vegos/TriggerAid/TriggerAid_prototype.jpg

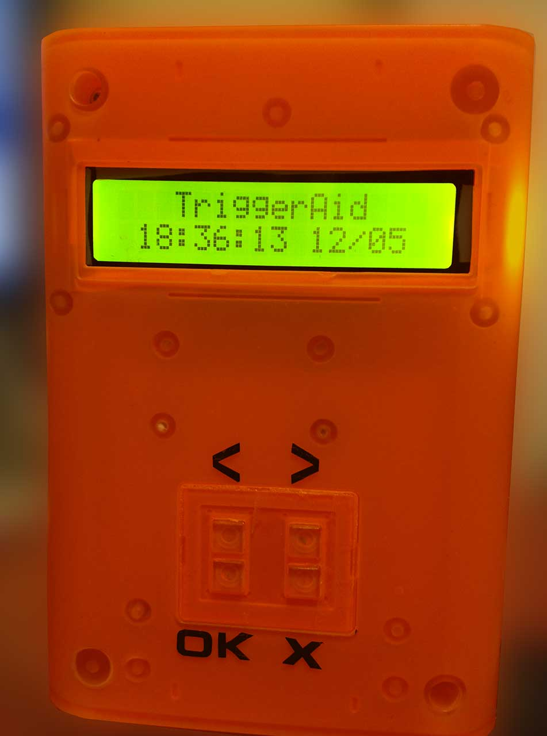
TriggerAid_prototype.jpg
