vegos/TriggerAid/TriggerAid2.jpg

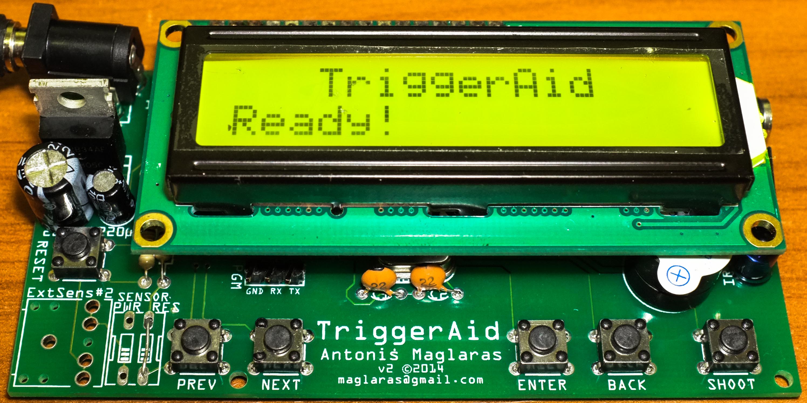
TriggerAid2.jpg
