vegos/TriggerAid/TriggerAidPCB.png

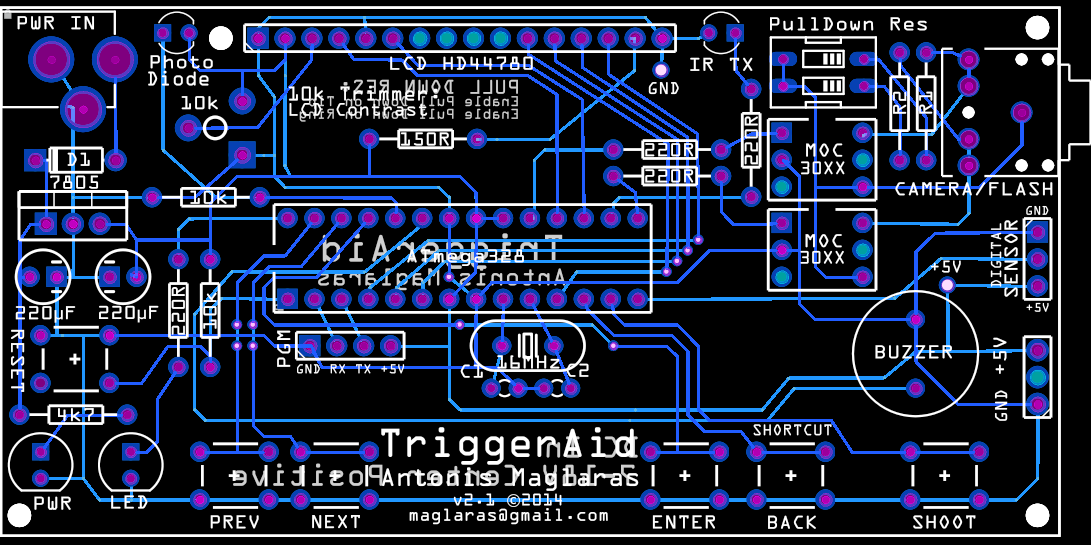
TriggerAidPCB.png
