vegos/TriggerAid/PCB/TriggerAid_etch_copper_bottom.pdf

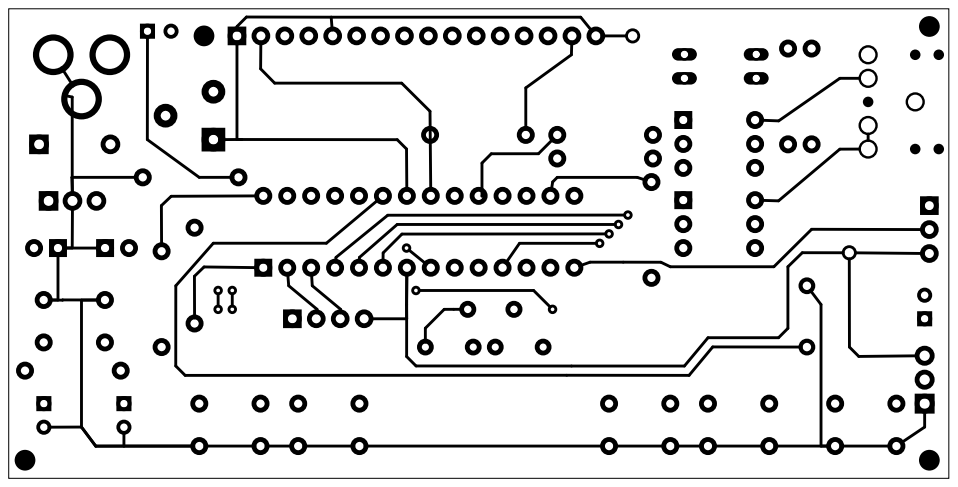
[picture p5: page 1]
