vegos/TriggerAid/PCB/TriggerAid_etch_copper_bottom_mirror.pdf

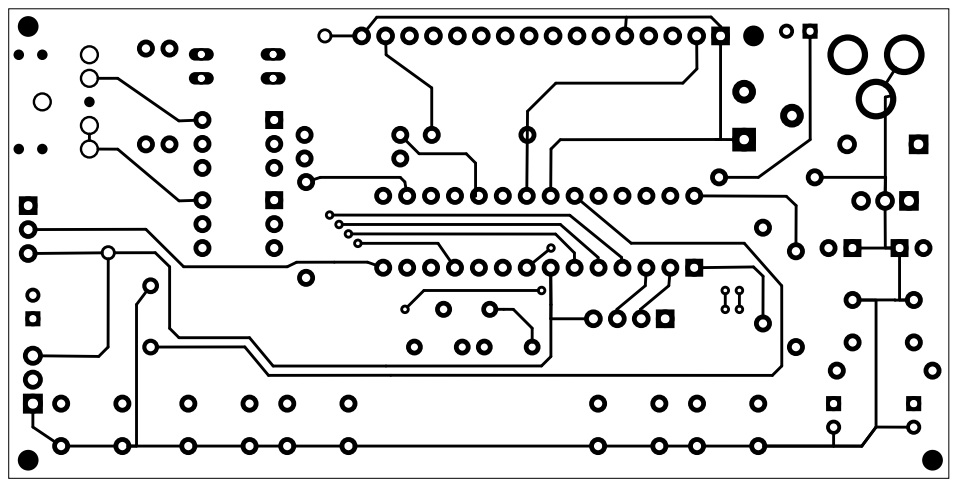
[picture p6: page 1]
