vegos/TriggerAid/PCB/TriggerAid_etch_copper_top.pdf

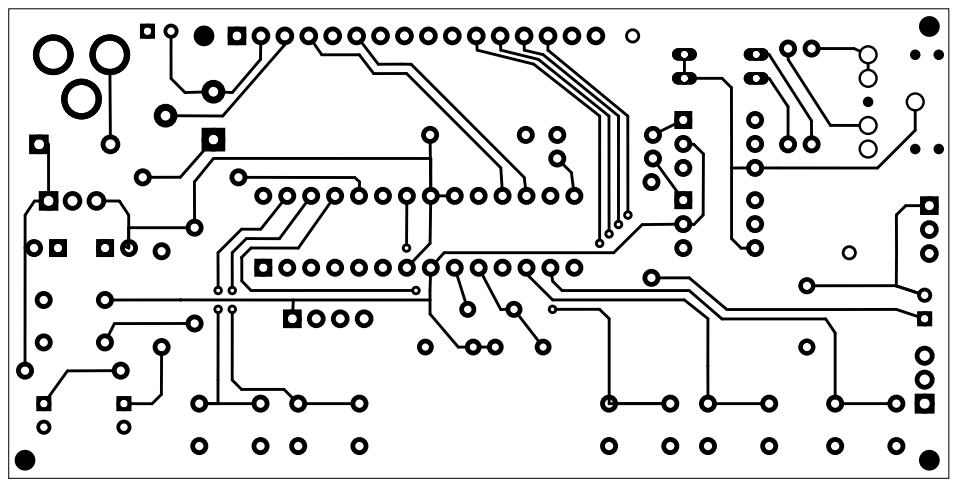
[picture p7: page 1]
