vegos/TriggerAid/PCB/TriggerAid_etch_copper_top_mirror.pdf

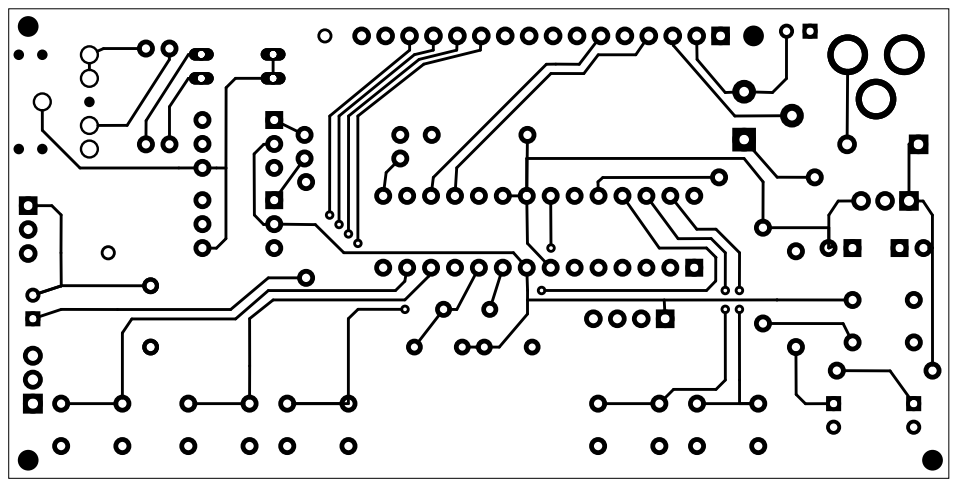
[picture p8: page 1]
