vegos/TriggerAid/PCB/TriggerAid_etch_mask_bottom.pdf

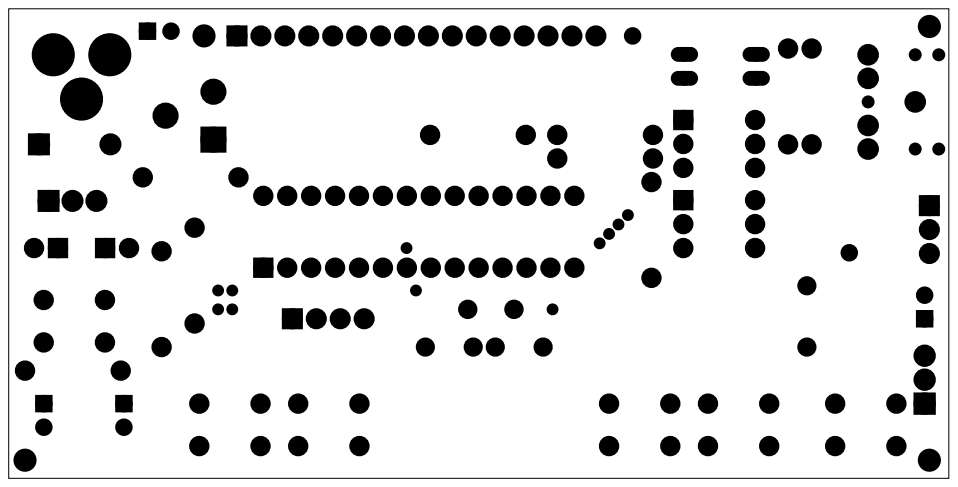
[picture p9: page 1]
