vegos/TriggerAid/PCB/TriggerAid_etch_mask_bottom_mirror.pdf

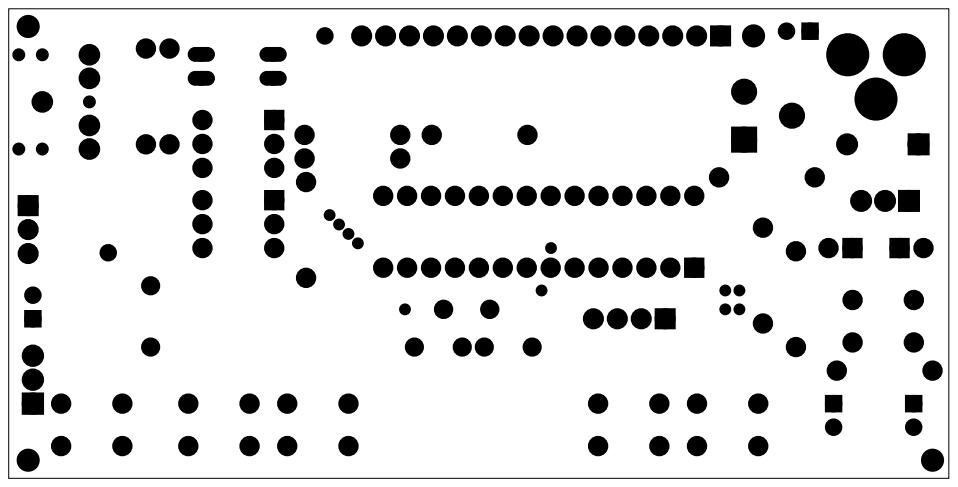
[picture p10: page 1]
