vegos/TriggerAid/PCB/TriggerAid_etch_mask_top.pdf

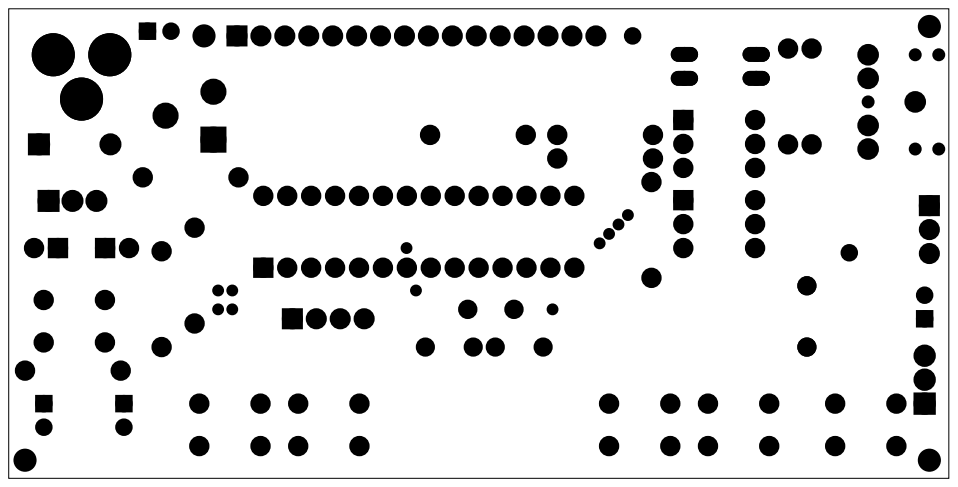
[picture p11: page 1]
