vegos/TriggerAid/PCB/TriggerAid_etch_mask_top_mirror.pdf

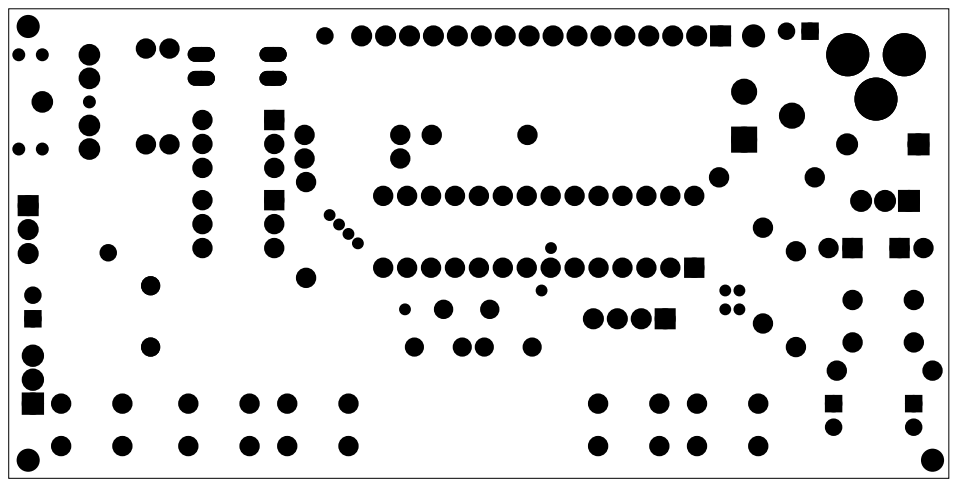
[picture p12: page 1]
