vegos/TriggerAid/PCB/TriggerAid_etch_silk_bottom.pdf

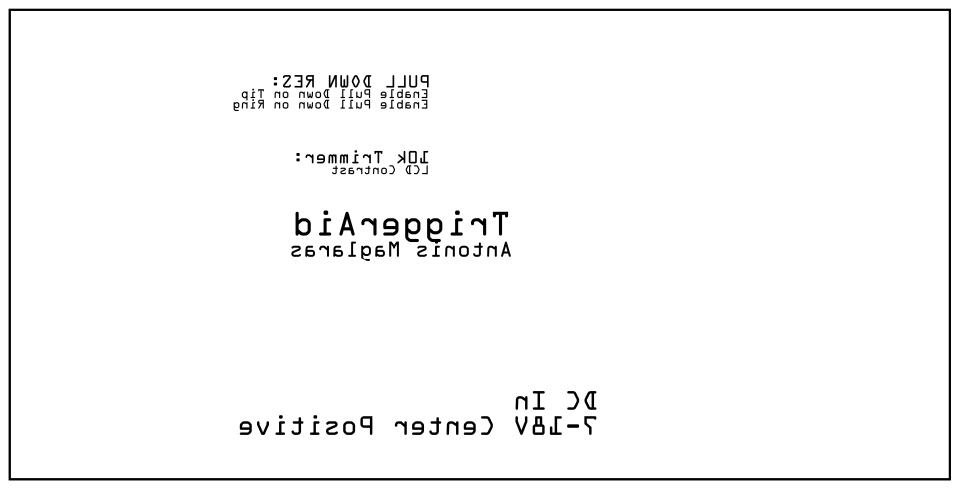
[picture p13: page 1]
