vegos/TriggerAid/PCB/TriggerAid_etch_silk_bottom_mirror.pdf

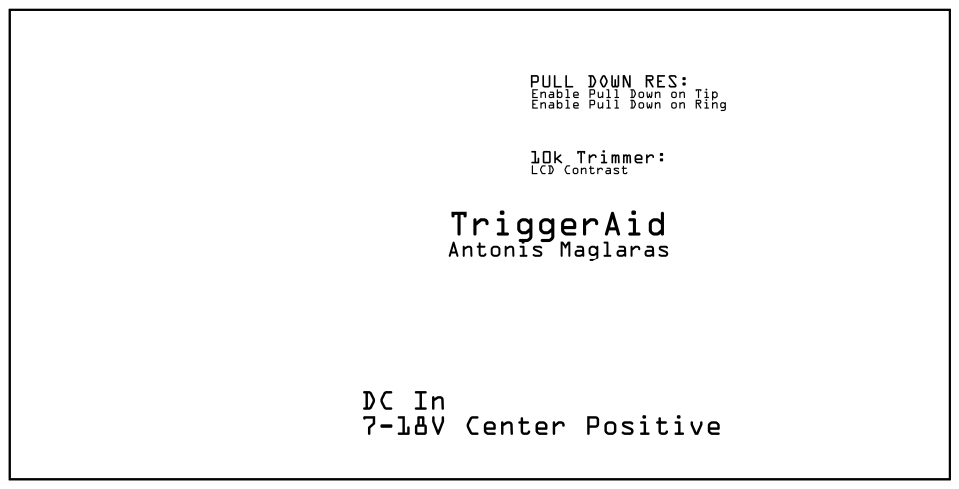
[picture p14: page 1]
