vegos/TriggerAid/PCB/TriggerAid_etch_silk_top.pdf

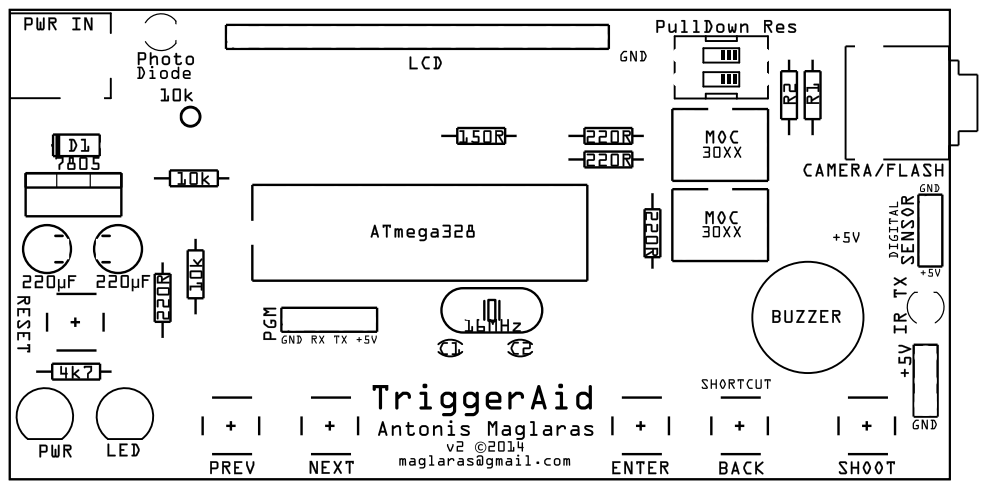
[picture p15: page 1]
