vegos/TriggerAid/PCB/TriggerAid_etch_silk_top_mirror.pdf

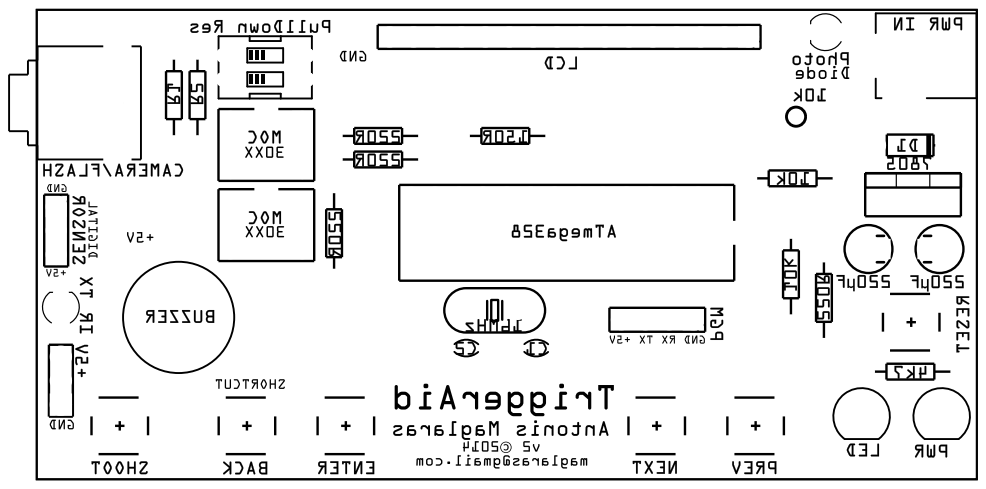
[picture p16: page 1]
