vegos/TriggerAid/(commit log)

2013-05-01 Added High Speed (Flash Units) Burst Mode (up to millisecond). Version 1.3.1
2013-05-02 Photo of the final product, in it's (painted) enclosure.
2013-05-13 Added option for selecting IR camera brand
2013-05-13 Hpoto of the final prototype
2014-06-29 Version 2.0.0 - PCB version
2014-06-29 Parts needed for the PCB v2.0
2014-06-29 PDF files for etching PCB
2014-06-30 Bug fixes, PCB is correct, code works ok!
    [TriggerAid.ino]
2014-07-02 Prototype photo
2014-07-02 Photo of the produced board @ working state
2014-07-06 v.2.1.6 - Bugfixes & minor improvements
    [TriggerAid.ino]
2014-07-12 v.2.1.8 -- Added self-timer feature & minor timing bugfixes
    [TriggerAid.ino]
